geroliux/Darduino/DIAGRAMA DE FLUJO FINAL.pdf

# START

# LED 1

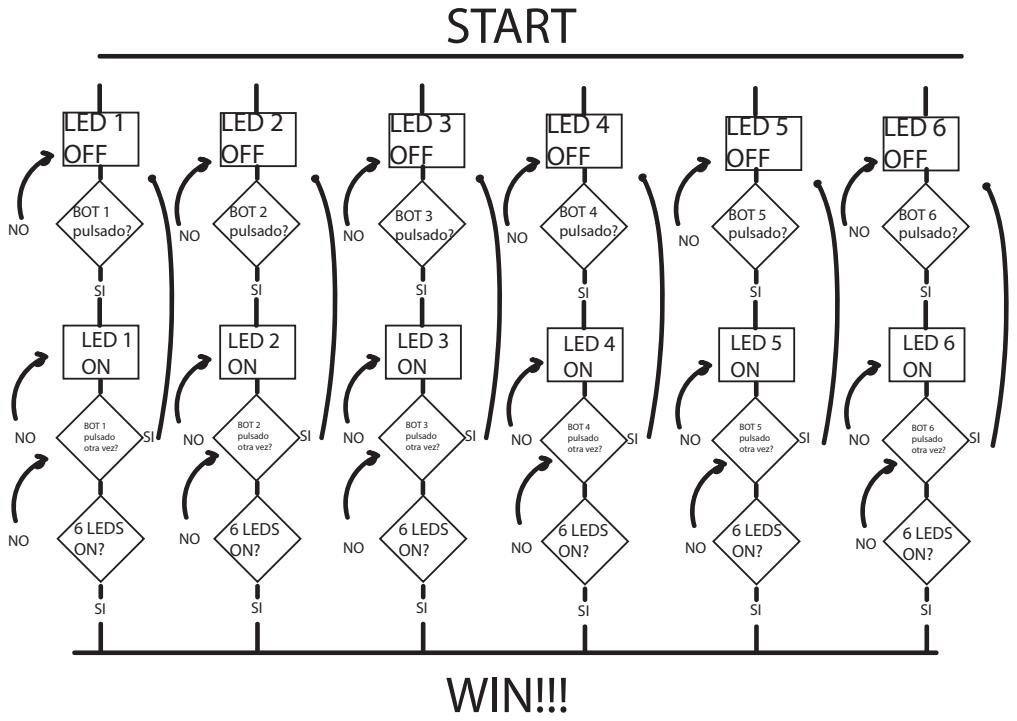
[picture p1: page 1]
OFF; WIN!!!; LED 2 OFF; LED 3 OFF; LED 4 OFF; LED 5 OFF; LED 6 OFF; BOT 1 pulsado?; BOT 2 pulsado?; BOT 3 pulsado?; BOT 4 pulsado?; BOT 5 pulsado?; BOT 6 pulsado?; LED 1 ON; LED 2 ON; LED 3 ON; LED 4 ON; LED 5 ON; LED 6 ON; BOT 1 pulsado otra vez?; BOT 2 pulsado otra vez?; BOT 3 pulsado otra vez?; BOT 4 pulsado otra vez?; BOT 5 pulsado otra vez?; BOT 6 pulsado otra vez?; 6 LEDS ON?
